jacob-wigent/esp32-handheld/README.md

# ESP32-S3 Handheld Game Console
Handheld game console powered by an ESP32-S3, featuring a custom LED matrix display and a variety of inputs.

ESP32-S3
2020 NeoPixels (WS2812B)
