jacob-wigent/esp32-handheld/hardware/motherboard/motherboard.kicad_pcb

## KiCad design hardware/motherboard/motherboard.kicad_pcb (2025-11-28)

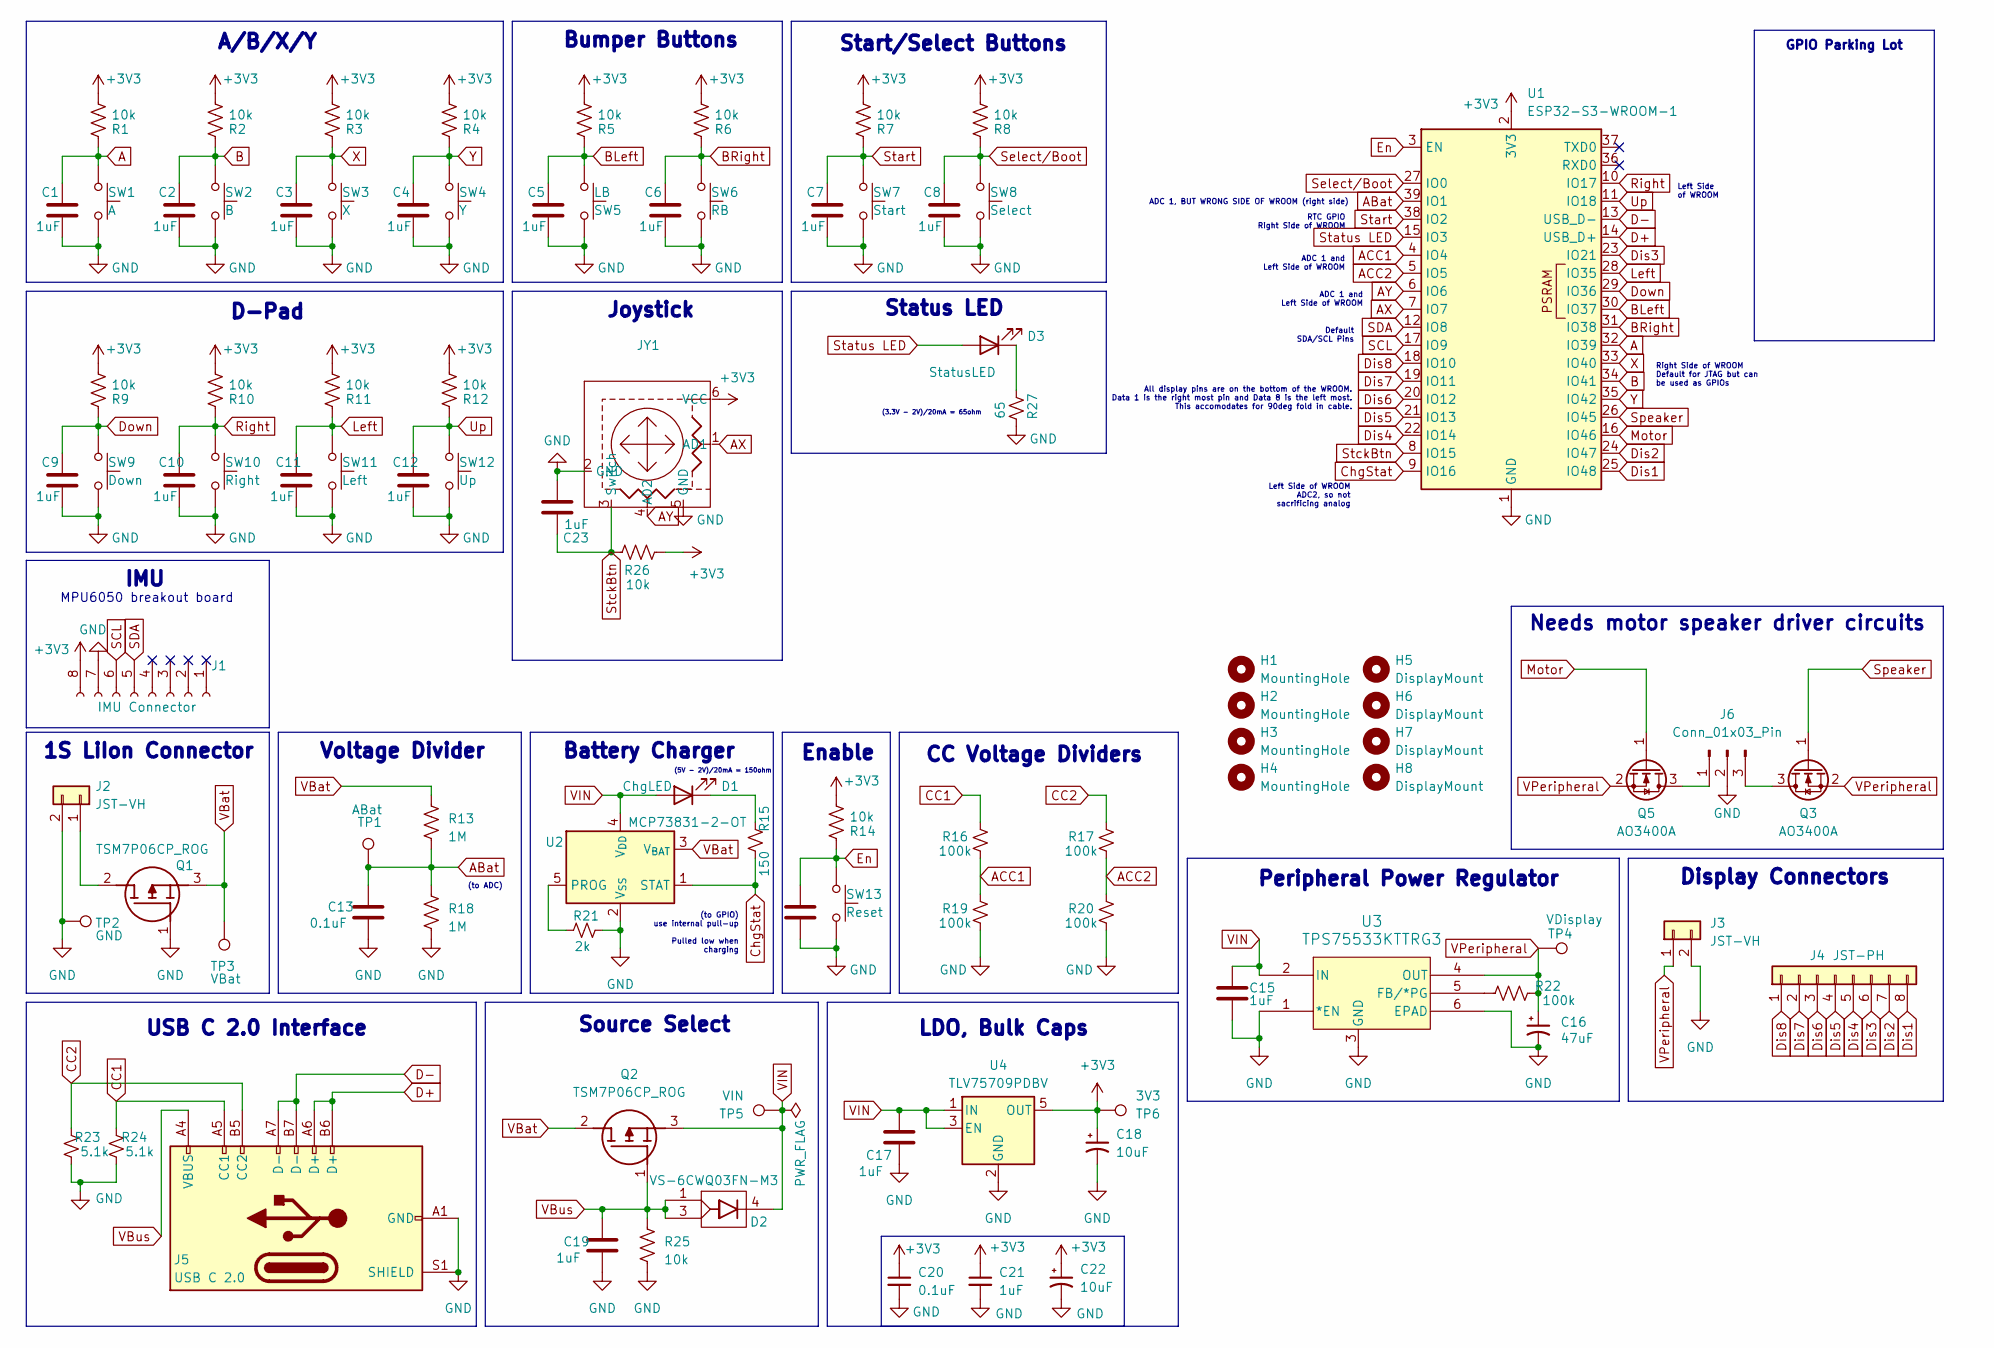
[picture p1: schematic motherboard.kicad_sch, Handheld Game Motherboard]

Parts:
C1, C2, C3, C4, C5, C6, C7, C8, C9, C10, C11, C12, C14, C15, C17, C19, C21, C23: 1uF; C_0805_2012Metric_Pad1.18x1.45mm_HandSolder
C13, C20: 0.1uF; C_0805_2012Metric_Pad1.18x1.45mm_HandSolder
C16: 47uF; CP_EIA-7343-31_Kemet-D
C18, C22: 10uF; C_0805_2012Metric_Pad1.18x1.45mm_HandSolder
D1: ChgLED; LED_1206_3216Metric_Pad1.42x1.75mm_HandSolder
D2: VS-6CWQ03FN-M3; DPAK_Q03FN-M3_VIS; Mouser Part Number 78-VS-6CWQ03FN-M3
D3: StatusLED; LED_1206_3216Metric_Pad1.42x1.75mm_HandSolder
H1, H2, H3, H4: MountingHole; MountingHole_3.2mm_M3_Pad
H5, H6, H7, H8: DisplayMount; MountingHole_3.2mm_M3_Pad
J1: IMU Connector; PinHeader_1x08_P2.54mm_Vertical
J2, J3: JST-VH; JST_VH_B2PS-VH_1x02_P3.96mm_Horizontal
J4: JST-PH; JST_PH_S8B-PH-K_1x08_P2.00mm_Horizontal
J5: USB C 2.0; USB_C_Receptacle_G-Switch_GT-USB-7010ASV
J6: Conn_01x03_Pin; JST_PH_S3B-PH-K_1x03_P2.00mm_Horizontal
JY1: Adafruit_Joycon
Q1, Q2: TSM7P06CP_ROG; TRANS_TSM7P06CP_ROG; Mouser Part Number 821-TSM7P06CPROG
Q3, Q5: AO3400A; SOT-23
R1, R2, R3, R4, R5, R6, R7, R8, R9, R10, R11, R12, R14, R25, R26: 10k; R_0805_2012Metric_Pad1.20x1.40mm_HandSolder
R13, R18: 1M; R_0805_2012Metric_Pad1.20x1.40mm_HandSolder
R15: 150; R_0805_2012Metric_Pad1.20x1.40mm_HandSolder
R16, R17, R19, R20, R22: 100k; R_0805_2012Metric_Pad1.20x1.40mm_HandSolder
R21: 2k; R_0805_2012Metric_Pad1.20x1.40mm_HandSolder
R23, R24: 5.1k; R_0805_2012Metric_Pad1.20x1.40mm_HandSolder
R27: 65; R_0805_2012Metric_Pad1.20x1.40mm_HandSolder
SW1: A; SW_PUSH_6mm
SW2: B; SW_PUSH_6mm
SW3: X; SW_PUSH_6mm
SW4: Y; SW_PUSH_6mm
SW5: LB; SW_Tactile_SPST_Angled_PTS645Vx58-2LFS
SW6: RB; SW_Tactile_SPST_Angled_PTS645Vx58-2LFS
SW7: Start; SW_PUSH_6mm
SW8: Select; SW_PUSH_6mm
SW9: Down; SW_PUSH_6mm
SW10: Right; SW_PUSH_6mm
SW11: Left; SW_PUSH_6mm
SW12: Up; SW_PUSH_6mm
SW13: Reset; SW_SPST_CK_RS282G05A3
TP1: ABat; TestPoint_Pad_D1.5mm
TP2: GND; TestPoint_Pad_D1.5mm
TP3: VBat; TestPoint_Pad_D1.5mm
TP4: VDisplay; TestPoint_Pad_D1.5mm
TP5: VIN; TestPoint_Pad_D1.5mm
TP6: 3V3; TestPoint_Pad_D1.5mm
U1: ESP32-S3-WROOM-1
U2: MCP73831-2-OT; SOT-23-5
U3: TPS75533KTTRG3; KTT5_6P22X6P86
U4: TLV75709PDBV; SOT-23-5

Connections:
+3V3: C18.1, C20.1, C21.1, C22.1, J1.8, JY1.6 (VCC), R1.2, R2.2, R3.2, R4.2, R5.2, R6.2, R7.2, R8.2, R9.2, R10.2, R11.2, R12.2, R14.2, R26.1, TP6.1, U1.2 (3V3), U4.5 (OUT)
A: C1.1, R1.1, SW1.1, U1.32 (IO39)
ABat: C13.1, R13.2, R18.1, TP1.1, U1.39 (IO1)
ACC1: R16.1, R19.2, U1.4 (IO4)
ACC2: R17.1, R20.2, U1.5 (IO5)
AX: JY1.1 (AD1), U1.7 (IO7)
AY: JY1.4 (AD2), U1.6 (IO6)
B: C2.1, R2.1, SW2.1, U1.34 (IO41)
BLeft: C5.1, R5.1, SW5.2, U1.30 (IO37)
BRight: C6.1, R6.1, SW6.1, U1.31 (IO38)
CC1: J5.A5 (CC1), R16.2, R24.2
CC2: J5.B5 (CC2), R17.2, R23.2
ChgStat: R15.1, U1.9 (IO16), U2.1 (STAT)
D+: J5.A6 (D+), J5.B6 (D+), U1.14 (USB_D+)
D-: J5.A7 (D-), J5.B7 (D-), U1.13 (USB_D-)
Dis1: J4.8, U1.25 (IO48)
Dis2: J4.7, U1.24 (IO47)
Dis3: J4.6, U1.23 (IO21)
Dis4: J4.5, U1.22 (IO14)
Dis5: J4.4, U1.21 (IO13)
Dis6: J4.3, U1.20 (IO12)
Dis7: J4.2, U1.19 (IO11)
Dis8: J4.1, U1.18 (IO10)
Down: C9.1, R9.1, SW9.1, U1.29 (IO36)
En: C14.1, R14.1, SW13.1, U1.3 (EN)
GND: C1.2, C2.2, C3.2, C4.2, C5.2, C6.2, C7.2, C8.2, C9.2, C10.2, C11.2, C12.2, C13.2, C14.2, C15.2, C16.2, C17.2, C18.2, C19.2, C20.2, C21.2, C22.2, C23.1, J1.7, J2.2, J3.2, J5.A1 (GND), J5.A12 (GND), J5.B1 (GND), J5.B12 (GND), J5.S1 (SHIELD), J6.2, JY1.2 (GND), JY1.5 (GND), Q1.1 (G), R18.2, R19.1, R20.1, R21.2, R23.1, R24.1, R25.2, R27.1, SW1.2, SW2.2, SW3.2, SW4.2, SW5.1, SW6.2, SW7.2, SW8.2, SW9.2, SW10.2, SW11.2, SW12.2, SW13.2, TP2.1, U1.1 (GND), U1.40 (GND), U1.41 (GND), U2.2 (V_{SS}), U3.1 (*EN), U3.3 (GND), U3.6 (EPAD), U4.2 (GND)
Left: C11.1, R11.1, SW11.1, U1.28 (IO35)
Motor: Q5.1 (G), U1.16 (IO46)
unnamed: D1.1 (K), R15.2
unnamed: D3.1 (K), R27.2
unnamed: J2.1, Q1.2 (D)
unnamed: J6.1, Q5.3 (D)
unnamed: J6.3, Q3.3 (D)
unnamed: R21.1, U2.5 (PROG)
unnamed: R22.1, U3.5 (FB/*PG)
Right: C10.1, R10.1, SW10.1, U1.10 (IO17)
SCL: J1.6, U1.17 (IO9)
SDA: J1.5, U1.12 (IO8)
Select/Boot: C8.1, R8.1, SW8.1, U1.27 (IO0)
Speaker: Q3.1 (G), U1.26 (IO45)
Start: C7.1, R7.1, SW7.1, U1.38 (IO2)
Status LED: D3.2 (A), U1.15 (IO3)
StckBtn: C23.2, JY1.3 (Switch), R26.2, U1.8 (IO15)
Up: C12.1, R12.1, SW12.1, U1.11 (IO18)
VBat: Q1.3 (S), Q2.2 (D), R13.1, TP3.1, U2.3 (V_{BAT})
VBus: C19.1, D2.1, D2.3, J5.A4 (VBUS), J5.A9 (VBUS), J5.B4 (VBUS), J5.B9 (VBUS), Q2.1 (G), R25.1
VIN: C15.1, C17.1, D1.2 (A), D2.4, Q2.3 (S), TP5.1, U2.4 (V_{DD}), U3.2 (IN), U4.1 (IN), U4.3 (EN)
VPeripheral: C16.1, J3.1, Q3.2 (S), Q5.2 (S), R22.2, TP4.1, U3.4 (OUT)
X: C3.1, R3.1, SW3.1, U1.33 (IO40)
Y: C4.1, R4.1, SW4.1, U1.35 (IO42)

Notes on the sheet:
(to GPIO) use internal pull-up Pulled low when charging
LDO, Bulk Caps
Left Side of WROOM
Bumper Buttons
Needs motor speaker driver circuits
Display Connectors
ADC 1 and Left Side of WROOM
Start/Select Buttons
USB C 2.0 Interface
1S LiIon Connector
CC Voltage Dividers
Right Side of WROOM Default for JTAG but can be used as GPIOs
Peripheral Power Regulator
Voltage Divider
D-Pad
(5V - 2V)/20mA = 150ohm
Source Select
IMU
(3.3V - 2V)/20mA = 65ohm
A/B/X/Y
All display pins are on the bottom of the WROOM. Data 1 is the right most pin and Data 8 is the left most. This accomodates for 90deg fold in cable.
MPU6050 breakout board
ADC 1, BUT WRONG SIDE OF WROOM (right side)
RTC GPIO Right Side of WROOM
Enable
Battery Charger
Joystick
GPIO Parking Lot
Left Side of WROOM ADC2, so not sacrificing analog
(to ADC)
Default SDA/SCL Pins
Status LED

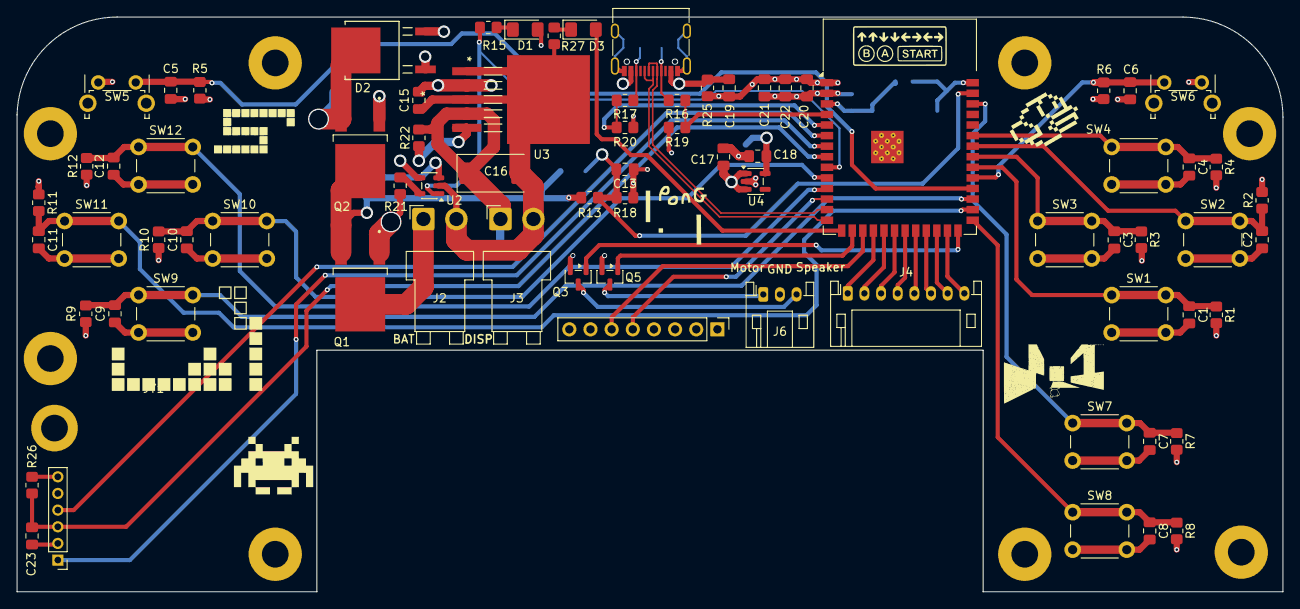
[picture p2: board motherboard.kicad_pcb from above]

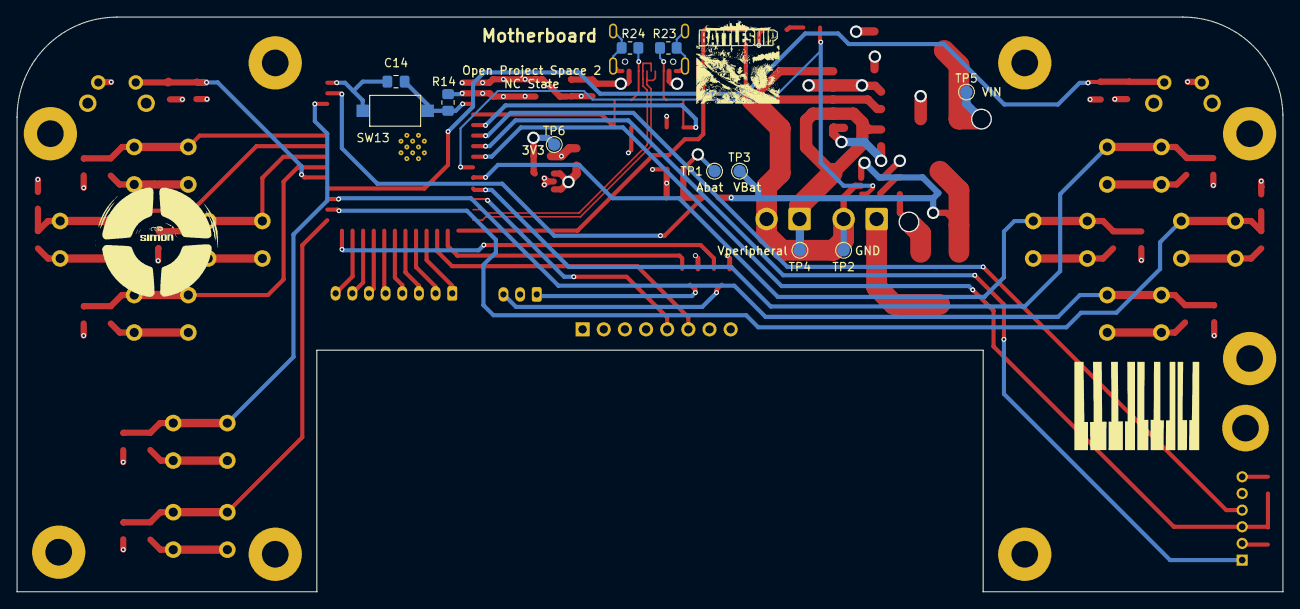
[picture p3: board motherboard.kicad_pcb from below]

Board: 4 copper layers, 152.0 x 69.0 mm, 95 parts (11 on the bottom side), 50 nets.
