jacob-wigent/esp32-handheld/hardware/display/display.kicad_pcb

## KiCad design hardware/display/display.kicad_pcb (2025-11-05)

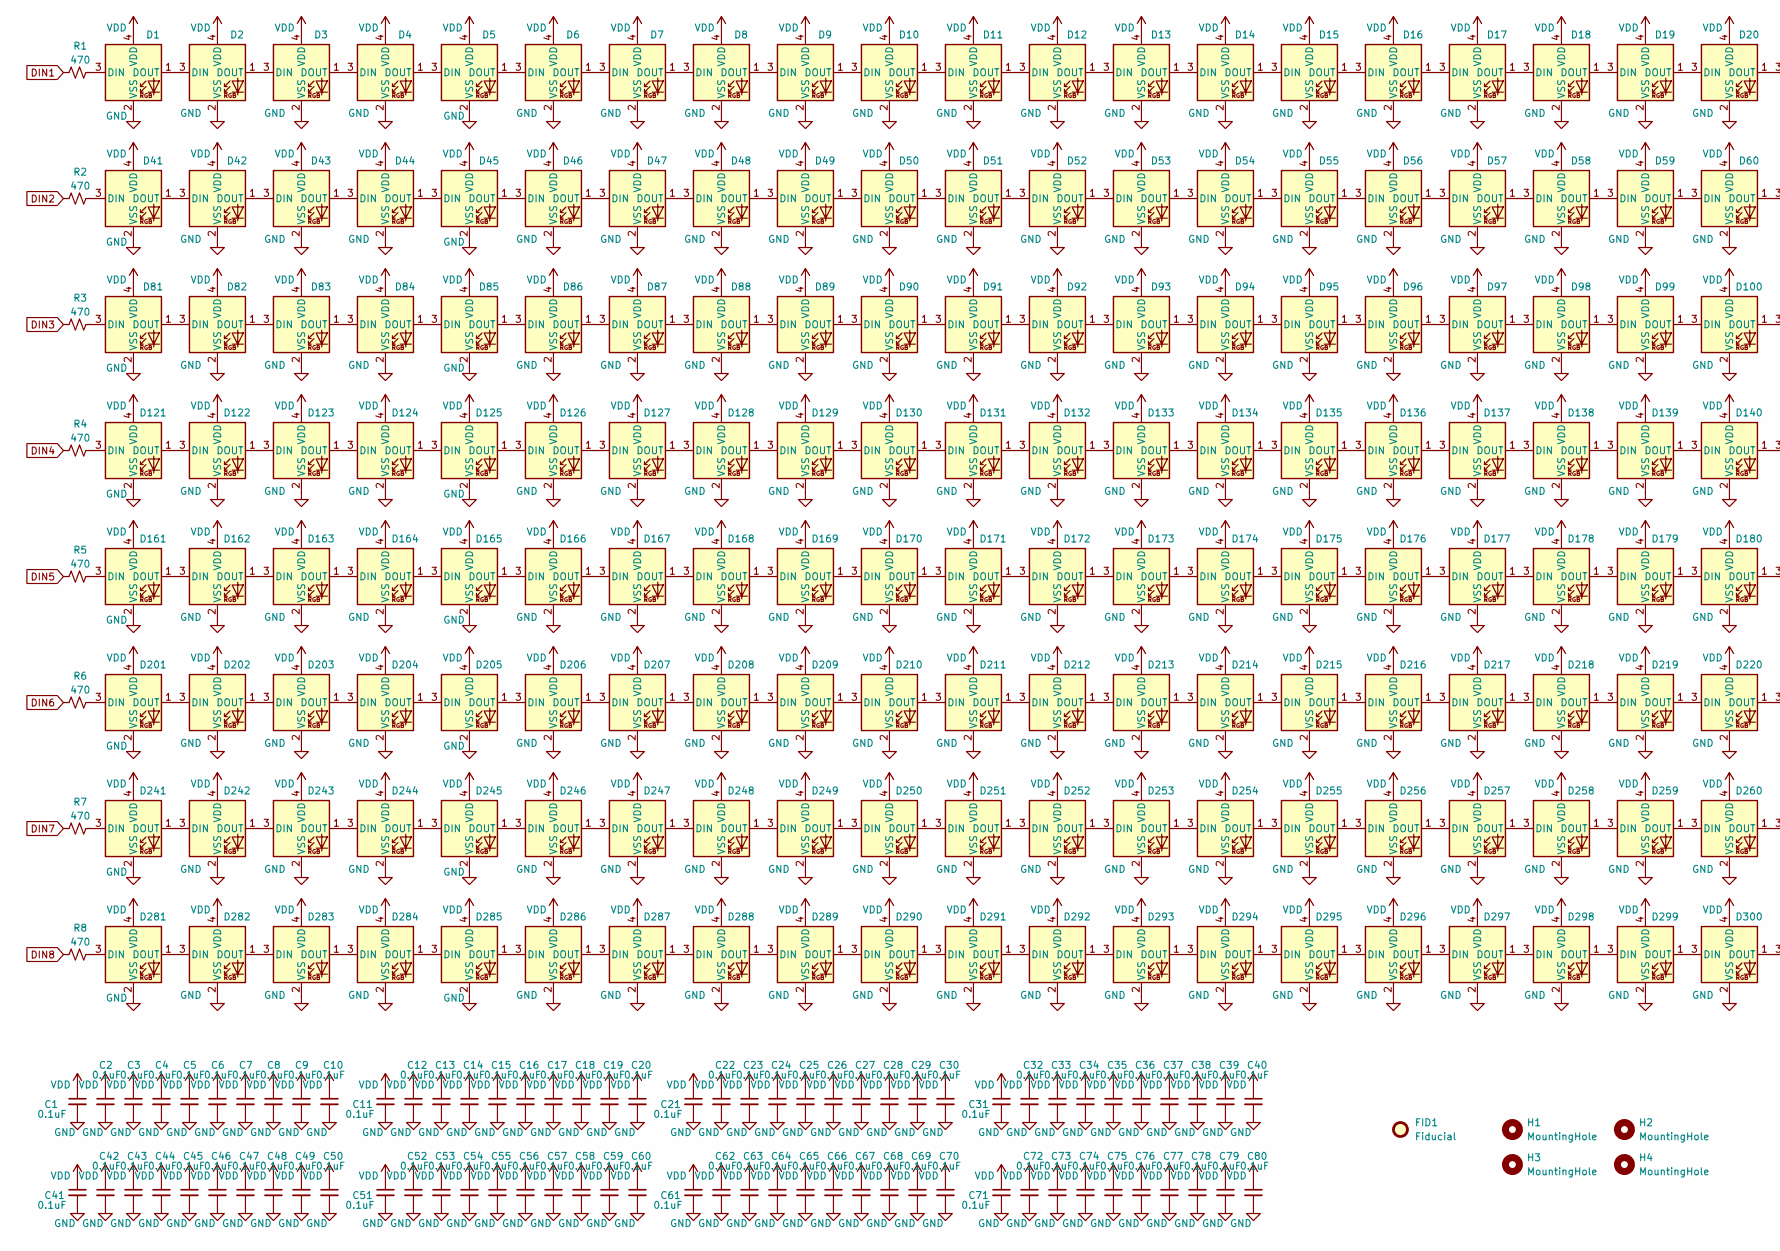
[picture p4: schematic display.kicad_sch, Display Board, part in row 1, column 1]

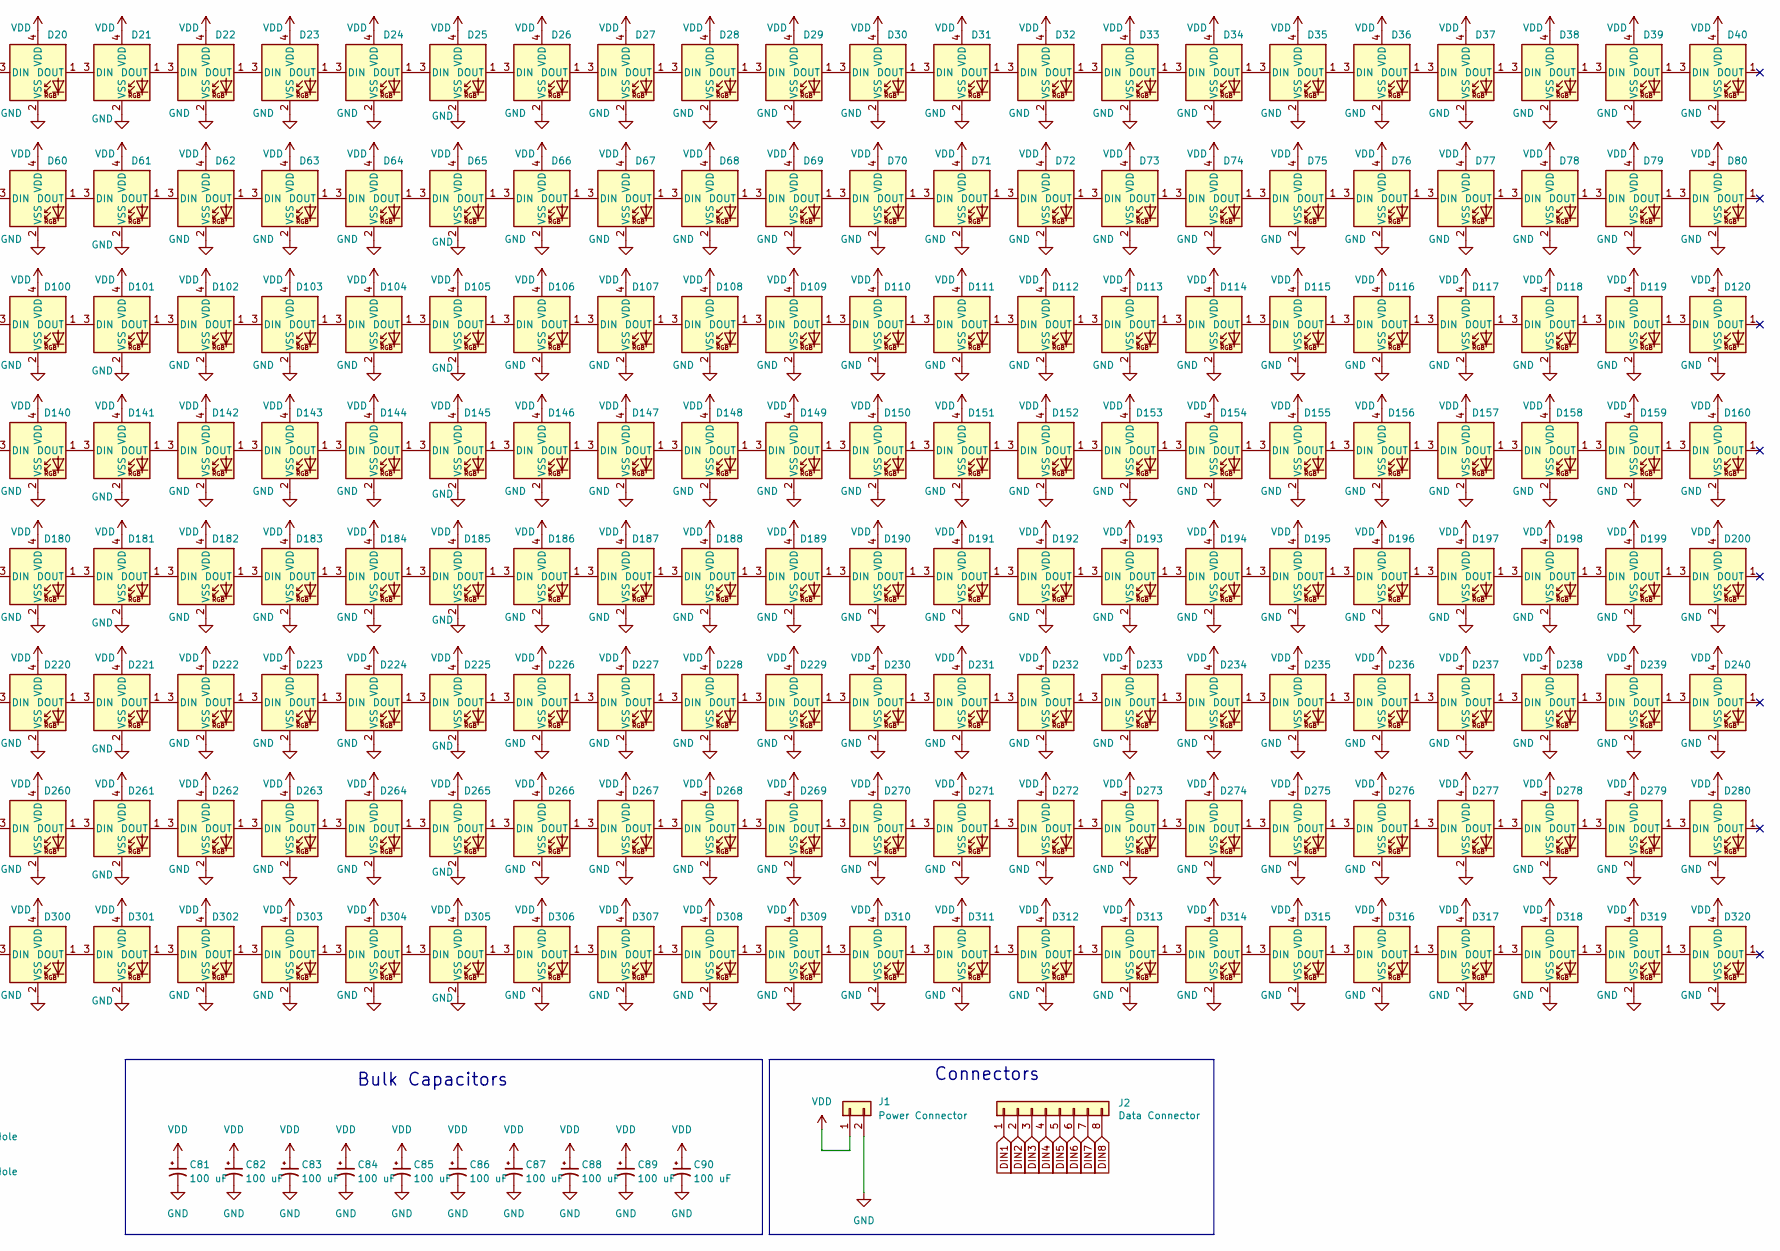
[picture p5: schematic display.kicad_sch, Display Board, part in row 1, column 2]

Parts:
C1, C2, C3, C4, C5, C6, C7, C8, C9, C10, C11, C12, C13, C14, C15, C16, C17, C18, C19, C20, C21, C22, C23, C24, C25, C26, C27, C28, C29, C30, C31, C32, C33, C34, C35, C36, C37, C38, C39, C40, C41, C42, C43, C44, C45, C46, C47, C48, C49, C50, C51, C52, C53, C54, C55, C56, C57, C58, C59, C60, C61, C62, C63, C64, C65, C66, C67, C68, C69, C70, C71, C72, C73, C74, C75, C76, C77, C78, C79, C80: 0.1uF; C_0402_1005Metric_Pad0.74x0.62mm_HandSolder
C81, C82, C83, C84, C85, C86, C87, C88, C89, C90: 100 uF; CAP_TAJ-D- 2917-S_AVX_NO_RESTRICTION
D1, D2, D3, D4, D5, D6, D7, D8, D9, D10, D11, D12, D13, D14, D15, D16, D17, D18, D19, D20, D21, D22, D23, D24, D25, D26, D27, D28, D29, D30, D31, D32, D33, D34, D35, D36, D37, D38, D39, D40, D41, D42, D43, D44, D45, D46, D47, D48, D49, D50, D51, D52, D53, D54, D55, D56, D57, D58, D59, D60, D61, D62, D63, D64, D65, D66, D67, D68, D69, D70, D71, D72, D73, D74, D75, D76, D77, D78, D79, D80, D81, D82, D83, D84, D85, D86, D87, D88, D89, D90, D91, D92, D93, D94, D95, D96, D97, D98, D99, D100, D101, D102, D103, D104, D105, D106, D107, D108, D109, D110, D111, D112, D113, D114, D115, D116, D117, D118, D119, D120, D121, D122, D123, D124, D125, D126, D127, D128, D129, D130, D131, D132, D133, D134, D135, D136, D137, D138, D139, D140, D141, D142, D143, D144, D145, D146, D147, D148, D149, D150, D151, D152, D153, D154, D155, D156, D157, D158, D159, D160, D161, D162, D163, D164, D165, D166, D167, D168, D169, D170, D171, D172, D173, D174, D175, D176, D177, D178, D179, D180, D181, D182, D183, D184, D185, D186, D187, D188, D189, D190, D191, D192, D193, D194, D195, D196, D197, D198, D199, D200, D201, D202, D203, D204, D205, D206, D207, D208, D209, D210, D211, D212, D213, D214, D215, D216, D217, D218, D219, D220, D221, D222, D223, D224, D225, D226, D227, D228, D229, D230, D231, D232, D233, D234, D235, D236, D237, D238, D239, D240, D241, D242, D243, D244, D245, D246, D247, D248, D249, D250, D251, D252, D253, D254, D255, D256, D257, D258, D259, D260, D261, D262, D263, D264, D265, D266, D267, D268, D269, D270, D271, D272, D273, D274, D275, D276, D277, D278, D279, D280, D281, D282, D283, D284, D285, D286, D287, D288, D289, D290, D291, D292, D293, D294, D295, D296, D297, D298, D299, D300, D301, D302, D303, D304, D305, D306, D307, D308, D309, D310, D311, D312, D313, D314, D315, D316, D317, D318, D319, D320: WS2812B-2020; LED_WS2812B-2020_PLCC4_2.0x2.0mm
FID1: Fiducial; Fiducial_1mm_Mask2mm
H1, H2, H3, H4: MountingHole; MountingHole_3.2mm_M3_Pad
J1: Power Connector; JST_VH_B2PS-VH_1x02_P3.96mm_Horizontal
J2: Data Connector; JST_PH_S8B-PH-K_1x08_P2.00mm_Horizontal
R1, R2, R3, R4, R5, R6, R7, R8: 470; R_0603_1608Metric_Pad0.98x0.95mm_HandSolder

Connections:
DIN1: J2.1, R1.1
DIN2: J2.2, R2.1
DIN3: J2.3, R3.1
DIN4: J2.4, R4.1
DIN5: J2.5, R5.1
DIN6: J2.6, R6.1
DIN7: J2.7, R7.1
DIN8: J2.8, R8.1
GND: C1.2, C2.2, C3.2, C4.2, C5.2, C6.2, C7.2, C8.2, C9.2, C10.2, C11.2, C12.2, C13.2, C14.2, C15.2, C16.2, C17.2, C18.2, C19.2, C20.2, C21.2, C22.2, C23.2, C24.2, C25.2, C26.2, C27.2, C28.2, C29.2, C30.2, C31.2, C32.2, C33.2, C34.2, C35.2, C36.2, C37.2, C38.2, C39.2, C40.2, C41.2, C42.2, C43.2, C44.2, C45.2, C46.2, C47.2, C48.2, C49.2, C50.2, C51.2, C52.2, C53.2, C54.2, C55.2, C56.2, C57.2, C58.2, C59.2, C60.2, C61.2, C62.2, C63.2, C64.2, C65.2, C66.2, C67.2, C68.2, C69.2, C70.2, C71.2, C72.2, C73.2, C74.2, C75.2, C76.2, C77.2, C78.2, C79.2, C80.2, C81.2, C82.2, C83.2, C84.2, C85.2, C86.2, C87.2, C88.2, C89.2, C90.2, D1.2 (VSS), D2.2 (VSS), D3.2 (VSS), D4.2 (VSS), D5.2 (VSS), D6.2 (VSS), D7.2 (VSS), D8.2 (VSS), D9.2 (VSS), D10.2 (VSS), D11.2 (VSS), D12.2 (VSS), D13.2 (VSS), D14.2 (VSS), D15.2 (VSS), D16.2 (VSS), D17.2 (VSS), D18.2 (VSS), D19.2 (VSS), D20.2 (VSS), D21.2 (VSS), D22.2 (VSS), D23.2 (VSS), D24.2 (VSS), D25.2 (VSS), D26.2 (VSS), D27.2 (VSS), D28.2 (VSS), D29.2 (VSS), D30.2 (VSS), D31.2 (VSS), D32.2 (VSS), D33.2 (VSS), D34.2 (VSS), D35.2 (VSS), D36.2 (VSS), D37.2 (VSS), D38.2 (VSS), D39.2 (VSS), D40.2 (VSS), D41.2 (VSS), D42.2 (VSS), D43.2 (VSS), D44.2 (VSS), D45.2 (VSS), D46.2 (VSS), D47.2 (VSS), D48.2 (VSS), D49.2 (VSS), D50.2 (VSS), D51.2 (VSS), D52.2 (VSS), D53.2 (VSS), D54.2 (VSS), D55.2 (VSS), D56.2 (VSS), D57.2 (VSS), D58.2 (VSS), D59.2 (VSS), D60.2 (VSS), D61.2 (VSS), D62.2 (VSS), D63.2 (VSS), D64.2 (VSS), D65.2 (VSS), D66.2 (VSS), D67.2 (VSS), D68.2 (VSS), D69.2 (VSS), D70.2 (VSS), D71.2 (VSS), D72.2 (VSS), D73.2 (VSS), D74.2 (VSS), D75.2 (VSS), D76.2 (VSS), D77.2 (VSS), D78.2 (VSS), D79.2 (VSS), D80.2 (VSS), D81.2 (VSS), D82.2 (VSS), D83.2 (VSS), D84.2 (VSS), D85.2 (VSS), D86.2 (VSS), D87.2 (VSS), D88.2 (VSS), D89.2 (VSS), D90.2 (VSS), D91.2 (VSS), D92.2 (VSS), D93.2 (VSS), D94.2 (VSS), D95.2 (VSS), D96.2 (VSS), D97.2 (VSS), D98.2 (VSS), D99.2 (VSS), D100.2 (VSS), D101.2 (VSS), D102.2 (VSS), D103.2 (VSS), D104.2 (VSS), D105.2 (VSS), D106.2 (VSS), D107.2 (VSS), D108.2 (VSS), D109.2 (VSS), D110.2 (VSS), D111.2 (VSS), D112.2 (VSS), D113.2 (VSS), D114.2 (VSS), D115.2 (VSS), D116.2 (VSS), D117.2 (VSS), D118.2 (VSS), D119.2 (VSS), D120.2 (VSS), D121.2 (VSS), D122.2 (VSS), D123.2 (VSS), D124.2 (VSS), D125.2 (VSS), D126.2 (VSS), D127.2 (VSS), D128.2 (VSS), D129.2 (VSS), D130.2 (VSS), D131.2 (VSS), D132.2 (VSS), D133.2 (VSS), D134.2 (VSS), D135.2 (VSS), D136.2 (VSS), D137.2 (VSS), D138.2 (VSS), D139.2 (VSS), D140.2 (VSS), D141.2 (VSS), D142.2 (VSS), D143.2 (VSS), D144.2 (VSS), D145.2 (VSS), D146.2 (VSS), D147.2 (VSS), D148.2 (VSS), D149.2 (VSS), D150.2 (VSS), D151.2 (VSS), D152.2 (VSS), D153.2 (VSS), D154.2 (VSS), D155.2 (VSS), D156.2 (VSS), D157.2 (VSS), D158.2 (VSS), D159.2 (VSS), D160.2 (VSS), D161.2 (VSS), D162.2 (VSS), D163.2 (VSS), D164.2 (VSS), D165.2 (VSS), D166.2 (VSS), D167.2 (VSS), D168.2 (VSS), D169.2 (VSS), D170.2 (VSS), D171.2 (VSS), D172.2 (VSS), D173.2 (VSS), D174.2 (VSS), D175.2 (VSS), D176.2 (VSS), D177.2 (VSS), D178.2 (VSS), D179.2 (VSS), D180.2 (VSS), D181.2 (VSS), D182.2 (VSS), D183.2 (VSS), D184.2 (VSS), D185.2 (VSS), D186.2 (VSS), D187.2 (VSS), D188.2 (VSS), D189.2 (VSS), D190.2 (VSS), D191.2 (VSS), D192.2 (VSS), D193.2 (VSS), D194.2 (VSS), D195.2 (VSS), D196.2 (VSS), D197.2 (VSS), D198.2 (VSS), D199.2 (VSS), D200.2 (VSS), D201.2 (VSS), D202.2 (VSS), D203.2 (VSS), D204.2 (VSS), D205.2 (VSS), D206.2 (VSS), D207.2 (VSS), D208.2 (VSS), D209.2 (VSS), D210.2 (VSS), D211.2 (VSS), D212.2 (VSS), D213.2 (VSS), D214.2 (VSS), D215.2 (VSS), D216.2 (VSS), D217.2 (VSS), D218.2 (VSS), D219.2 (VSS), D220.2 (VSS), D221.2 (VSS), D222.2 (VSS), D223.2 (VSS), D224.2 (VSS), D225.2 (VSS), D226.2 (VSS), D227.2 (VSS), D228.2 (VSS), D229.2 (VSS), D230.2 (VSS), D231.2 (VSS), D232.2 (VSS), D233.2 (VSS), D234.2 (VSS), D235.2 (VSS), D236.2 (VSS), D237.2 (VSS), D238.2 (VSS), D239.2 (VSS), D240.2 (VSS), D241.2 (VSS), D242.2 (VSS), D243.2 (VSS), D244.2 (VSS), D245.2 (VSS), D246.2 (VSS), D247.2 (VSS), D248.2 (VSS), D249.2 (VSS), D250.2 (VSS), D251.2 (VSS), D252.2 (VSS), D253.2 (VSS), D254.2 (VSS), D255.2 (VSS), D256.2 (VSS), D257.2 (VSS), D258.2 (VSS), D259.2 (VSS), D260.2 (VSS), D261.2 (VSS), D262.2 (VSS), D263.2 (VSS), D264.2 (VSS), D265.2 (VSS), D266.2 (VSS), D267.2 (VSS), D268.2 (VSS), D269.2 (VSS), D270.2 (VSS), D271.2 (VSS), D272.2 (VSS), D273.2 (VSS), D274.2 (VSS), D275.2 (VSS), D276.2 (VSS), D277.2 (VSS), D278.2 (VSS), D279.2 (VSS), D280.2 (VSS), D281.2 (VSS), D282.2 (VSS), D283.2 (VSS), D284.2 (VSS), D285.2 (VSS), D286.2 (VSS), D287.2 (VSS), D288.2 (VSS), D289.2 (VSS), D290.2 (VSS), D291.2 (VSS), D292.2 (VSS), D293.2 (VSS), D294.2 (VSS), D295.2 (VSS), D296.2 (VSS), D297.2 (VSS), D298.2 (VSS), D299.2 (VSS), D300.2 (VSS), D301.2 (VSS), D302.2 (VSS), D303.2 (VSS), D304.2 (VSS), D305.2 (VSS), D306.2 (VSS), D307.2 (VSS), D308.2 (VSS), D309.2 (VSS), D310.2 (VSS), D311.2 (VSS), D312.2 (VSS), D313.2 (VSS), D314.2 (VSS), D315.2 (VSS), D316.2 (VSS), D317.2 (VSS), D318.2 (VSS), D319.2 (VSS), D320.2 (VSS), J1.2
unnamed: D1.3 (DIN), R1.2
unnamed: D1.1 (DOUT), D2.3 (DIN)
unnamed: D2.1 (DOUT), D3.3 (DIN)
unnamed: D3.1 (DOUT), D4.3 (DIN)
unnamed: D4.1 (DOUT), D5.3 (DIN)
unnamed: D5.1 (DOUT), D6.3 (DIN)
unnamed: D6.1 (DOUT), D7.3 (DIN)
unnamed: D7.1 (DOUT), D8.3 (DIN)
unnamed: D8.1 (DOUT), D9.3 (DIN)
unnamed: D9.1 (DOUT), D10.3 (DIN)
unnamed: D10.1 (DOUT), D11.3 (DIN)
unnamed: D11.1 (DOUT), D12.3 (DIN)
unnamed: D12.1 (DOUT), D13.3 (DIN)
unnamed: D13.1 (DOUT), D14.3 (DIN)
unnamed: D14.1 (DOUT), D15.3 (DIN)
unnamed: D15.1 (DOUT), D16.3 (DIN)
unnamed: D16.1 (DOUT), D17.3 (DIN)
unnamed: D17.1 (DOUT), D18.3 (DIN)
unnamed: D18.1 (DOUT), D19.3 (DIN)
unnamed: D19.1 (DOUT), D20.3 (DIN)
unnamed: D20.1 (DOUT), D21.3 (DIN)
unnamed: D21.1 (DOUT), D22.3 (DIN)
unnamed: D22.1 (DOUT), D23.3 (DIN)
unnamed: D23.1 (DOUT), D24.3 (DIN)
unnamed: D24.1 (DOUT), D25.3 (DIN)
unnamed: D25.1 (DOUT), D26.3 (DIN)
unnamed: D26.1 (DOUT), D27.3 (DIN)
unnamed: D27.1 (DOUT), D28.3 (DIN)
unnamed: D28.1 (DOUT), D29.3 (DIN)
unnamed: D29.1 (DOUT), D30.3 (DIN)
unnamed: D30.1 (DOUT), D31.3 (DIN)
unnamed: D31.1 (DOUT), D32.3 (DIN)
unnamed: D32.1 (DOUT), D33.3 (DIN)
unnamed: D33.1 (DOUT), D34.3 (DIN)
unnamed: D34.1 (DOUT), D35.3 (DIN)
unnamed: D35.1 (DOUT), D36.3 (DIN)
unnamed: D36.1 (DOUT), D37.3 (DIN)
unnamed: D37.1 (DOUT), D38.3 (DIN)
unnamed: D38.1 (DOUT), D39.3 (DIN)
unnamed: D39.1 (DOUT), D40.3 (DIN)
unnamed: D41.3 (DIN), R2.2
unnamed: D41.1 (DOUT), D42.3 (DIN)
unnamed: D42.1 (DOUT), D43.3 (DIN)
unnamed: D43.1 (DOUT), D44.3 (DIN)
unnamed: D44.1 (DOUT), D45.3 (DIN)
unnamed: D45.1 (DOUT), D46.3 (DIN)
unnamed: D46.1 (DOUT), D47.3 (DIN)
unnamed: D47.1 (DOUT), D48.3 (DIN)
unnamed: D48.1 (DOUT), D49.3 (DIN)
unnamed: D49.1 (DOUT), D50.3 (DIN)
unnamed: D50.1 (DOUT), D51.3 (DIN)
unnamed: D51.1 (DOUT), D52.3 (DIN)
unnamed: D52.1 (DOUT), D53.3 (DIN)
unnamed: D53.1 (DOUT), D54.3 (DIN)
unnamed: D54.1 (DOUT), D55.3 (DIN)
unnamed: D55.1 (DOUT), D56.3 (DIN)
unnamed: D56.1 (DOUT), D57.3 (DIN)
unnamed: D57.1 (DOUT), D58.3 (DIN)
unnamed: D58.1 (DOUT), D59.3 (DIN)
unnamed: D59.1 (DOUT), D60.3 (DIN)
unnamed: D60.1 (DOUT), D61.3 (DIN)
unnamed: D61.1 (DOUT), D62.3 (DIN)
unnamed: D62.1 (DOUT), D63.3 (DIN)
unnamed: D63.1 (DOUT), D64.3 (DIN)
unnamed: D64.1 (DOUT), D65.3 (DIN)
unnamed: D65.1 (DOUT), D66.3 (DIN)
unnamed: D66.1 (DOUT), D67.3 (DIN)
unnamed: D67.1 (DOUT), D68.3 (DIN)
unnamed: D68.1 (DOUT), D69.3 (DIN)
unnamed: D69.1 (DOUT), D70.3 (DIN)
unnamed: D70.1 (DOUT), D71.3 (DIN)
unnamed: D71.1 (DOUT), D72.3 (DIN)
unnamed: D72.1 (DOUT), D73.3 (DIN)
unnamed: D73.1 (DOUT), D74.3 (DIN)
unnamed: D74.1 (DOUT), D75.3 (DIN)
unnamed: D75.1 (DOUT), D76.3 (DIN)
unnamed: D76.1 (DOUT), D77.3 (DIN)
unnamed: D77.1 (DOUT), D78.3 (DIN)
unnamed: D78.1 (DOUT), D79.3 (DIN)
unnamed: D79.1 (DOUT), D80.3 (DIN)
unnamed: D81.3 (DIN), R3.2
unnamed: D81.1 (DOUT), D82.3 (DIN)
unnamed: D82.1 (DOUT), D83.3 (DIN)
unnamed: D83.1 (DOUT), D84.3 (DIN)
unnamed: D84.1 (DOUT), D85.3 (DIN)
unnamed: D85.1 (DOUT), D86.3 (DIN)
unnamed: D86.1 (DOUT), D87.3 (DIN)
unnamed: D87.1 (DOUT), D88.3 (DIN)
unnamed: D88.1 (DOUT), D89.3 (DIN)
unnamed: D89.1 (DOUT), D90.3 (DIN)
unnamed: D90.1 (DOUT), D91.3 (DIN)
unnamed: D91.1 (DOUT), D92.3 (DIN)
unnamed: D92.1 (DOUT), D93.3 (DIN)
unnamed: D93.1 (DOUT), D94.3 (DIN)
unnamed: D94.1 (DOUT), D95.3 (DIN)
unnamed: D95.1 (DOUT), D96.3 (DIN)
unnamed: D96.1 (DOUT), D97.3 (DIN)
unnamed: D97.1 (DOUT), D98.3 (DIN)
unnamed: D98.1 (DOUT), D99.3 (DIN)
unnamed: D99.1 (DOUT), D100.3 (DIN)
unnamed: D100.1 (DOUT), D101.3 (DIN)
unnamed: D101.1 (DOUT), D102.3 (DIN)
unnamed: D102.1 (DOUT), D103.3 (DIN)
unnamed: D103.1 (DOUT), D104.3 (DIN)
unnamed: D104.1 (DOUT), D105.3 (DIN)
unnamed: D105.1 (DOUT), D106.3 (DIN)
unnamed: D106.1 (DOUT), D107.3 (DIN)
unnamed: D107.1 (DOUT), D108.3 (DIN)
unnamed: D108.1 (DOUT), D109.3 (DIN)
unnamed: D109.1 (DOUT), D110.3 (DIN)
unnamed: D110.1 (DOUT), D111.3 (DIN)
unnamed: D111.1 (DOUT), D112.3 (DIN)
unnamed: D112.1 (DOUT), D113.3 (DIN)
unnamed: D113.1 (DOUT), D114.3 (DIN)
unnamed: D114.1 (DOUT), D115.3 (DIN)
unnamed: D115.1 (DOUT), D116.3 (DIN)
unnamed: D116.1 (DOUT), D117.3 (DIN)
unnamed: D117.1 (DOUT), D118.3 (DIN)
unnamed: D118.1 (DOUT), D119.3 (DIN)
unnamed: D119.1 (DOUT), D120.3 (DIN)
unnamed: D121.3 (DIN), R4.2
unnamed: D121.1 (DOUT), D122.3 (DIN)
unnamed: D122.1 (DOUT), D123.3 (DIN)
unnamed: D123.1 (DOUT), D124.3 (DIN)
unnamed: D124.1 (DOUT), D125.3 (DIN)
unnamed: D125.1 (DOUT), D126.3 (DIN)
unnamed: D126.1 (DOUT), D127.3 (DIN)
unnamed: D127.1 (DOUT), D128.3 (DIN)
unnamed: D128.1 (DOUT), D129.3 (DIN)
unnamed: D129.1 (DOUT), D130.3 (DIN)
unnamed: D130.1 (DOUT), D131.3 (DIN)
unnamed: D131.1 (DOUT), D132.3 (DIN)
unnamed: D132.1 (DOUT), D133.3 (DIN)
unnamed: D133.1 (DOUT), D134.3 (DIN)
unnamed: D134.1 (DOUT), D135.3 (DIN)
unnamed: D135.1 (DOUT), D136.3 (DIN)
unnamed: D136.1 (DOUT), D137.3 (DIN)
unnamed: D137.1 (DOUT), D138.3 (DIN)
unnamed: D138.1 (DOUT), D139.3 (DIN)
unnamed: D139.1 (DOUT), D140.3 (DIN)
unnamed: D140.1 (DOUT), D141.3 (DIN)
unnamed: D141.1 (DOUT), D142.3 (DIN)
unnamed: D142.1 (DOUT), D143.3 (DIN)
unnamed: D143.1 (DOUT), D144.3 (DIN)
unnamed: D144.1 (DOUT), D145.3 (DIN)
unnamed: D145.1 (DOUT), D146.3 (DIN)
unnamed: D146.1 (DOUT), D147.3 (DIN)
unnamed: D147.1 (DOUT), D148.3 (DIN)
unnamed: D148.1 (DOUT), D149.3 (DIN)
unnamed: D149.1 (DOUT), D150.3 (DIN)
unnamed: D150.1 (DOUT), D151.3 (DIN)
unnamed: D151.1 (DOUT), D152.3 (DIN)
unnamed: D152.1 (DOUT), D153.3 (DIN)
unnamed: D153.1 (DOUT), D154.3 (DIN)
unnamed: D154.1 (DOUT), D155.3 (DIN)
unnamed: D155.1 (DOUT), D156.3 (DIN)
unnamed: D156.1 (DOUT), D157.3 (DIN)
unnamed: D157.1 (DOUT), D158.3 (DIN)
unnamed: D158.1 (DOUT), D159.3 (DIN)
unnamed: D159.1 (DOUT), D160.3 (DIN)
unnamed: D161.3 (DIN), R5.2
unnamed: D161.1 (DOUT), D162.3 (DIN)
unnamed: D162.1 (DOUT), D163.3 (DIN)
unnamed: D163.1 (DOUT), D164.3 (DIN)
unnamed: D164.1 (DOUT), D165.3 (DIN)
unnamed: D165.1 (DOUT), D166.3 (DIN)
unnamed: D166.1 (DOUT), D167.3 (DIN)
unnamed: D167.1 (DOUT), D168.3 (DIN)
unnamed: D168.1 (DOUT), D169.3 (DIN)
unnamed: D169.1 (DOUT), D170.3 (DIN)
unnamed: D170.1 (DOUT), D171.3 (DIN)
unnamed: D171.1 (DOUT), D172.3 (DIN)
unnamed: D172.1 (DOUT), D173.3 (DIN)
unnamed: D173.1 (DOUT), D174.3 (DIN)
unnamed: D174.1 (DOUT), D175.3 (DIN)
unnamed: D175.1 (DOUT), D176.3 (DIN)
unnamed: D176.1 (DOUT), D177.3 (DIN)
unnamed: D177.1 (DOUT), D178.3 (DIN)
unnamed: D178.1 (DOUT), D179.3 (DIN)
unnamed: D179.1 (DOUT), D180.3 (DIN)
unnamed: D180.1 (DOUT), D181.3 (DIN)
unnamed: D181.1 (DOUT), D182.3 (DIN)
unnamed: D182.1 (DOUT), D183.3 (DIN)
unnamed: D183.1 (DOUT), D184.3 (DIN)
unnamed: D184.1 (DOUT), D185.3 (DIN)
unnamed: D185.1 (DOUT), D186.3 (DIN)
unnamed: D186.1 (DOUT), D187.3 (DIN)
unnamed: D187.1 (DOUT), D188.3 (DIN)
unnamed: D188.1 (DOUT), D189.3 (DIN)
unnamed: D189.1 (DOUT), D190.3 (DIN)
unnamed: D190.1 (DOUT), D191.3 (DIN)
unnamed: D191.1 (DOUT), D192.3 (DIN)
unnamed: D192.1 (DOUT), D193.3 (DIN)
unnamed: D193.1 (DOUT), D194.3 (DIN)
unnamed: D194.1 (DOUT), D195.3 (DIN)
unnamed: D195.1 (DOUT), D196.3 (DIN)
unnamed: D196.1 (DOUT), D197.3 (DIN)
unnamed: D197.1 (DOUT), D198.3 (DIN)
unnamed: D198.1 (DOUT), D199.3 (DIN)
unnamed: D199.1 (DOUT), D200.3 (DIN)
unnamed: D201.3 (DIN), R6.2
unnamed: D201.1 (DOUT), D202.3 (DIN)
unnamed: D202.1 (DOUT), D203.3 (DIN)
unnamed: D203.1 (DOUT), D204.3 (DIN)
unnamed: D204.1 (DOUT), D205.3 (DIN)
unnamed: D205.1 (DOUT), D206.3 (DIN)
unnamed: D206.1 (DOUT), D207.3 (DIN)
unnamed: D207.1 (DOUT), D208.3 (DIN)
unnamed: D208.1 (DOUT), D209.3 (DIN)
unnamed: D209.1 (DOUT), D210.3 (DIN)
unnamed: D210.1 (DOUT), D211.3 (DIN)
unnamed: D211.1 (DOUT), D212.3 (DIN)
unnamed: D212.1 (DOUT), D213.3 (DIN)
unnamed: D213.1 (DOUT), D214.3 (DIN)
unnamed: D214.1 (DOUT), D215.3 (DIN)
unnamed: D215.1 (DOUT), D216.3 (DIN)
unnamed: D216.1 (DOUT), D217.3 (DIN)
unnamed: D217.1 (DOUT), D218.3 (DIN)
unnamed: D218.1 (DOUT), D219.3 (DIN)
unnamed: D219.1 (DOUT), D220.3 (DIN)
unnamed: D220.1 (DOUT), D221.3 (DIN)
unnamed: D221.1 (DOUT), D222.3 (DIN)
unnamed: D222.1 (DOUT), D223.3 (DIN)
unnamed: D223.1 (DOUT), D224.3 (DIN)
unnamed: D224.1 (DOUT), D225.3 (DIN)
unnamed: D225.1 (DOUT), D226.3 (DIN)
unnamed: D226.1 (DOUT), D227.3 (DIN)
unnamed: D227.1 (DOUT), D228.3 (DIN)
unnamed: D228.1 (DOUT), D229.3 (DIN)
unnamed: D229.1 (DOUT), D230.3 (DIN)
unnamed: D230.1 (DOUT), D231.3 (DIN)
unnamed: D231.1 (DOUT), D232.3 (DIN)
unnamed: D232.1 (DOUT), D233.3 (DIN)
unnamed: D233.1 (DOUT), D234.3 (DIN)
unnamed: D234.1 (DOUT), D235.3 (DIN)
unnamed: D235.1 (DOUT), D236.3 (DIN)
unnamed: D236.1 (DOUT), D237.3 (DIN)
unnamed: D237.1 (DOUT), D238.3 (DIN)
unnamed: D238.1 (DOUT), D239.3 (DIN)
unnamed: D239.1 (DOUT), D240.3 (DIN)
unnamed: D241.3 (DIN), R7.2
unnamed: D241.1 (DOUT), D242.3 (DIN)
unnamed: D242.1 (DOUT), D243.3 (DIN)
unnamed: D243.1 (DOUT), D244.3 (DIN)
unnamed: D244.1 (DOUT), D245.3 (DIN)
unnamed: D245.1 (DOUT), D246.3 (DIN)
unnamed: D246.1 (DOUT), D247.3 (DIN)
unnamed: D247.1 (DOUT), D248.3 (DIN)
unnamed: D248.1 (DOUT), D249.3 (DIN)
unnamed: D249.1 (DOUT), D250.3 (DIN)
unnamed: D250.1 (DOUT), D251.3 (DIN)
unnamed: D251.1 (DOUT), D252.3 (DIN)
unnamed: D252.1 (DOUT), D253.3 (DIN)
unnamed: D253.1 (DOUT), D254.3 (DIN)
unnamed: D254.1 (DOUT), D255.3 (DIN)
unnamed: D255.1 (DOUT), D256.3 (DIN)
unnamed: D256.1 (DOUT), D257.3 (DIN)
unnamed: D257.1 (DOUT), D258.3 (DIN)
unnamed: D258.1 (DOUT), D259.3 (DIN)
unnamed: D259.1 (DOUT), D260.3 (DIN)
unnamed: D260.1 (DOUT), D261.3 (DIN)
unnamed: D261.1 (DOUT), D262.3 (DIN)
unnamed: D262.1 (DOUT), D263.3 (DIN)
unnamed: D263.1 (DOUT), D264.3 (DIN)
unnamed: D264.1 (DOUT), D265.3 (DIN)
unnamed: D265.1 (DOUT), D266.3 (DIN)
unnamed: D266.1 (DOUT), D267.3 (DIN)
unnamed: D267.1 (DOUT), D268.3 (DIN)
unnamed: D268.1 (DOUT), D269.3 (DIN)
unnamed: D269.1 (DOUT), D270.3 (DIN)
unnamed: D270.1 (DOUT), D271.3 (DIN)
unnamed: D271.1 (DOUT), D272.3 (DIN)
unnamed: D272.1 (DOUT), D273.3 (DIN)
unnamed: D273.1 (DOUT), D274.3 (DIN)
unnamed: D274.1 (DOUT), D275.3 (DIN)
unnamed: D275.1 (DOUT), D276.3 (DIN)
unnamed: D276.1 (DOUT), D277.3 (DIN)
unnamed: D277.1 (DOUT), D278.3 (DIN)
unnamed: D278.1 (DOUT), D279.3 (DIN)
unnamed: D279.1 (DOUT), D280.3 (DIN)
unnamed: D281.3 (DIN), R8.2
unnamed: D281.1 (DOUT), D282.3 (DIN)
unnamed: D282.1 (DOUT), D283.3 (DIN)
unnamed: D283.1 (DOUT), D284.3 (DIN)
unnamed: D284.1 (DOUT), D285.3 (DIN)
unnamed: D285.1 (DOUT), D286.3 (DIN)
unnamed: D286.1 (DOUT), D287.3 (DIN)
unnamed: D287.1 (DOUT), D288.3 (DIN)
unnamed: D288.1 (DOUT), D289.3 (DIN)
unnamed: D289.1 (DOUT), D290.3 (DIN)
unnamed: D290.1 (DOUT), D291.3 (DIN)
unnamed: D291.1 (DOUT), D292.3 (DIN)
unnamed: D292.1 (DOUT), D293.3 (DIN)
unnamed: D293.1 (DOUT), D294.3 (DIN)
unnamed: D294.1 (DOUT), D295.3 (DIN)
unnamed: D295.1 (DOUT), D296.3 (DIN)
unnamed: D296.1 (DOUT), D297.3 (DIN)
unnamed: D297.1 (DOUT), D298.3 (DIN)
unnamed: D298.1 (DOUT), D299.3 (DIN)
unnamed: D299.1 (DOUT), D300.3 (DIN)
unnamed: D300.1 (DOUT), D301.3 (DIN)
unnamed: D301.1 (DOUT), D302.3 (DIN)
unnamed: D302.1 (DOUT), D303.3 (DIN)
unnamed: D303.1 (DOUT), D304.3 (DIN)
unnamed: D304.1 (DOUT), D305.3 (DIN)
unnamed: D305.1 (DOUT), D306.3 (DIN)
unnamed: D306.1 (DOUT), D307.3 (DIN)
unnamed: D307.1 (DOUT), D308.3 (DIN)
unnamed: D308.1 (DOUT), D309.3 (DIN)
unnamed: D309.1 (DOUT), D310.3 (DIN)
unnamed: D310.1 (DOUT), D311.3 (DIN)
unnamed: D311.1 (DOUT), D312.3 (DIN)
unnamed: D312.1 (DOUT), D313.3 (DIN)
unnamed: D313.1 (DOUT), D314.3 (DIN)
unnamed: D314.1 (DOUT), D315.3 (DIN)
unnamed: D315.1 (DOUT), D316.3 (DIN)
unnamed: D316.1 (DOUT), D317.3 (DIN)
unnamed: D317.1 (DOUT), D318.3 (DIN)
unnamed: D318.1 (DOUT), D319.3 (DIN)
unnamed: D319.1 (DOUT), D320.3 (DIN)
VDD: C1.1, C2.1, C3.1, C4.1, C5.1, C6.1, C7.1, C8.1, C9.1, C10.1, C11.1, C12.1, C13.1, C14.1, C15.1, C16.1, C17.1, C18.1, C19.1, C20.1, C21.1, C22.1, C23.1, C24.1, C25.1, C26.1, C27.1, C28.1, C29.1, C30.1, C31.1, C32.1, C33.1, C34.1, C35.1, C36.1, C37.1, C38.1, C39.1, C40.1, C41.1, C42.1, C43.1, C44.1, C45.1, C46.1, C47.1, C48.1, C49.1, C50.1, C51.1, C52.1, C53.1, C54.1, C55.1, C56.1, C57.1, C58.1, C59.1, C60.1, C61.1, C62.1, C63.1, C64.1, C65.1, C66.1, C67.1, C68.1, C69.1, C70.1, C71.1, C72.1, C73.1, C74.1, C75.1, C76.1, C77.1, C78.1, C79.1, C80.1, C81.1, C82.1, C83.1, C84.1, C85.1, C86.1, C87.1, C88.1, C89.1, C90.1, D1.4 (VDD), D2.4 (VDD), D3.4 (VDD), D4.4 (VDD), D5.4 (VDD), D6.4 (VDD), D7.4 (VDD), D8.4 (VDD), D9.4 (VDD), D10.4 (VDD), D11.4 (VDD), D12.4 (VDD), D13.4 (VDD), D14.4 (VDD), D15.4 (VDD), D16.4 (VDD), D17.4 (VDD), D18.4 (VDD), D19.4 (VDD), D20.4 (VDD), D21.4 (VDD), D22.4 (VDD), D23.4 (VDD), D24.4 (VDD), D25.4 (VDD), D26.4 (VDD), D27.4 (VDD), D28.4 (VDD), D29.4 (VDD), D30.4 (VDD), D31.4 (VDD), D32.4 (VDD), D33.4 (VDD), D34.4 (VDD), D35.4 (VDD), D36.4 (VDD), D37.4 (VDD), D38.4 (VDD), D39.4 (VDD), D40.4 (VDD), D41.4 (VDD), D42.4 (VDD), D43.4 (VDD), D44.4 (VDD), D45.4 (VDD), D46.4 (VDD), D47.4 (VDD), D48.4 (VDD), D49.4 (VDD), D50.4 (VDD), D51.4 (VDD), D52.4 (VDD), D53.4 (VDD), D54.4 (VDD), D55.4 (VDD), D56.4 (VDD), D57.4 (VDD), D58.4 (VDD), D59.4 (VDD), D60.4 (VDD), D61.4 (VDD), D62.4 (VDD), D63.4 (VDD), D64.4 (VDD), D65.4 (VDD), D66.4 (VDD), D67.4 (VDD), D68.4 (VDD), D69.4 (VDD), D70.4 (VDD), D71.4 (VDD), D72.4 (VDD), D73.4 (VDD), D74.4 (VDD), D75.4 (VDD), D76.4 (VDD), D77.4 (VDD), D78.4 (VDD), D79.4 (VDD), D80.4 (VDD), D81.4 (VDD), D82.4 (VDD), D83.4 (VDD), D84.4 (VDD), D85.4 (VDD), D86.4 (VDD), D87.4 (VDD), D88.4 (VDD), D89.4 (VDD), D90.4 (VDD), D91.4 (VDD), D92.4 (VDD), D93.4 (VDD), D94.4 (VDD), D95.4 (VDD), D96.4 (VDD), D97.4 (VDD), D98.4 (VDD), D99.4 (VDD), D100.4 (VDD), D101.4 (VDD), D102.4 (VDD), D103.4 (VDD), D104.4 (VDD), D105.4 (VDD), D106.4 (VDD), D107.4 (VDD), D108.4 (VDD), D109.4 (VDD), D110.4 (VDD), D111.4 (VDD), D112.4 (VDD), D113.4 (VDD), D114.4 (VDD), D115.4 (VDD), D116.4 (VDD), D117.4 (VDD), D118.4 (VDD), D119.4 (VDD), D120.4 (VDD), D121.4 (VDD), D122.4 (VDD), D123.4 (VDD), D124.4 (VDD), D125.4 (VDD), D126.4 (VDD), D127.4 (VDD), D128.4 (VDD), D129.4 (VDD), D130.4 (VDD), D131.4 (VDD), D132.4 (VDD), D133.4 (VDD), D134.4 (VDD), D135.4 (VDD), D136.4 (VDD), D137.4 (VDD), D138.4 (VDD), D139.4 (VDD), D140.4 (VDD), D141.4 (VDD), D142.4 (VDD), D143.4 (VDD), D144.4 (VDD), D145.4 (VDD), D146.4 (VDD), D147.4 (VDD), D148.4 (VDD), D149.4 (VDD), D150.4 (VDD), D151.4 (VDD), D152.4 (VDD), D153.4 (VDD), D154.4 (VDD), D155.4 (VDD), D156.4 (VDD), D157.4 (VDD), D158.4 (VDD), D159.4 (VDD), D160.4 (VDD), D161.4 (VDD), D162.4 (VDD), D163.4 (VDD), D164.4 (VDD), D165.4 (VDD), D166.4 (VDD), D167.4 (VDD), D168.4 (VDD), D169.4 (VDD), D170.4 (VDD), D171.4 (VDD), D172.4 (VDD), D173.4 (VDD), D174.4 (VDD), D175.4 (VDD), D176.4 (VDD), D177.4 (VDD), D178.4 (VDD), D179.4 (VDD), D180.4 (VDD), D181.4 (VDD), D182.4 (VDD), D183.4 (VDD), D184.4 (VDD), D185.4 (VDD), D186.4 (VDD), D187.4 (VDD), D188.4 (VDD), D189.4 (VDD), D190.4 (VDD), D191.4 (VDD), D192.4 (VDD), D193.4 (VDD), D194.4 (VDD), D195.4 (VDD), D196.4 (VDD), D197.4 (VDD), D198.4 (VDD), D199.4 (VDD), D200.4 (VDD), D201.4 (VDD), D202.4 (VDD), D203.4 (VDD), D204.4 (VDD), D205.4 (VDD), D206.4 (VDD), D207.4 (VDD), D208.4 (VDD), D209.4 (VDD), D210.4 (VDD), D211.4 (VDD), D212.4 (VDD), D213.4 (VDD), D214.4 (VDD), D215.4 (VDD), D216.4 (VDD), D217.4 (VDD), D218.4 (VDD), D219.4 (VDD), D220.4 (VDD), D221.4 (VDD), D222.4 (VDD), D223.4 (VDD), D224.4 (VDD), D225.4 (VDD), D226.4 (VDD), D227.4 (VDD), D228.4 (VDD), D229.4 (VDD), D230.4 (VDD), D231.4 (VDD), D232.4 (VDD), D233.4 (VDD), D234.4 (VDD), D235.4 (VDD), D236.4 (VDD), D237.4 (VDD), D238.4 (VDD), D239.4 (VDD), D240.4 (VDD), D241.4 (VDD), D242.4 (VDD), D243.4 (VDD), D244.4 (VDD), D245.4 (VDD), D246.4 (VDD), D247.4 (VDD), D248.4 (VDD), D249.4 (VDD), D250.4 (VDD), D251.4 (VDD), D252.4 (VDD), D253.4 (VDD), D254.4 (VDD), D255.4 (VDD), D256.4 (VDD), D257.4 (VDD), D258.4 (VDD), D259.4 (VDD), D260.4 (VDD), D261.4 (VDD), D262.4 (VDD), D263.4 (VDD), D264.4 (VDD), D265.4 (VDD), D266.4 (VDD), D267.4 (VDD), D268.4 (VDD), D269.4 (VDD), D270.4 (VDD), D271.4 (VDD), D272.4 (VDD), D273.4 (VDD), D274.4 (VDD), D275.4 (VDD), D276.4 (VDD), D277.4 (VDD), D278.4 (VDD), D279.4 (VDD), D280.4 (VDD), D281.4 (VDD), D282.4 (VDD), D283.4 (VDD), D284.4 (VDD), D285.4 (VDD), D286.4 (VDD), D287.4 (VDD), D288.4 (VDD), D289.4 (VDD), D290.4 (VDD), D291.4 (VDD), D292.4 (VDD), D293.4 (VDD), D294.4 (VDD), D295.4 (VDD), D296.4 (VDD), D297.4 (VDD), D298.4 (VDD), D299.4 (VDD), D300.4 (VDD), D301.4 (VDD), D302.4 (VDD), D303.4 (VDD), D304.4 (VDD), D305.4 (VDD), D306.4 (VDD), D307.4 (VDD), D308.4 (VDD), D309.4 (VDD), D310.4 (VDD), D311.4 (VDD), D312.4 (VDD), D313.4 (VDD), D314.4 (VDD), D315.4 (VDD), D316.4 (VDD), D317.4 (VDD), D318.4 (VDD), D319.4 (VDD), D320.4 (VDD), J1.1

Notes on the sheet:
Bulk Capacitors
Connectors
