jacob-wigent/esp32-handheld/hardware/display/display.kicad_pcb

## KiCad design hardware/display/display.kicad_pcb (continued)

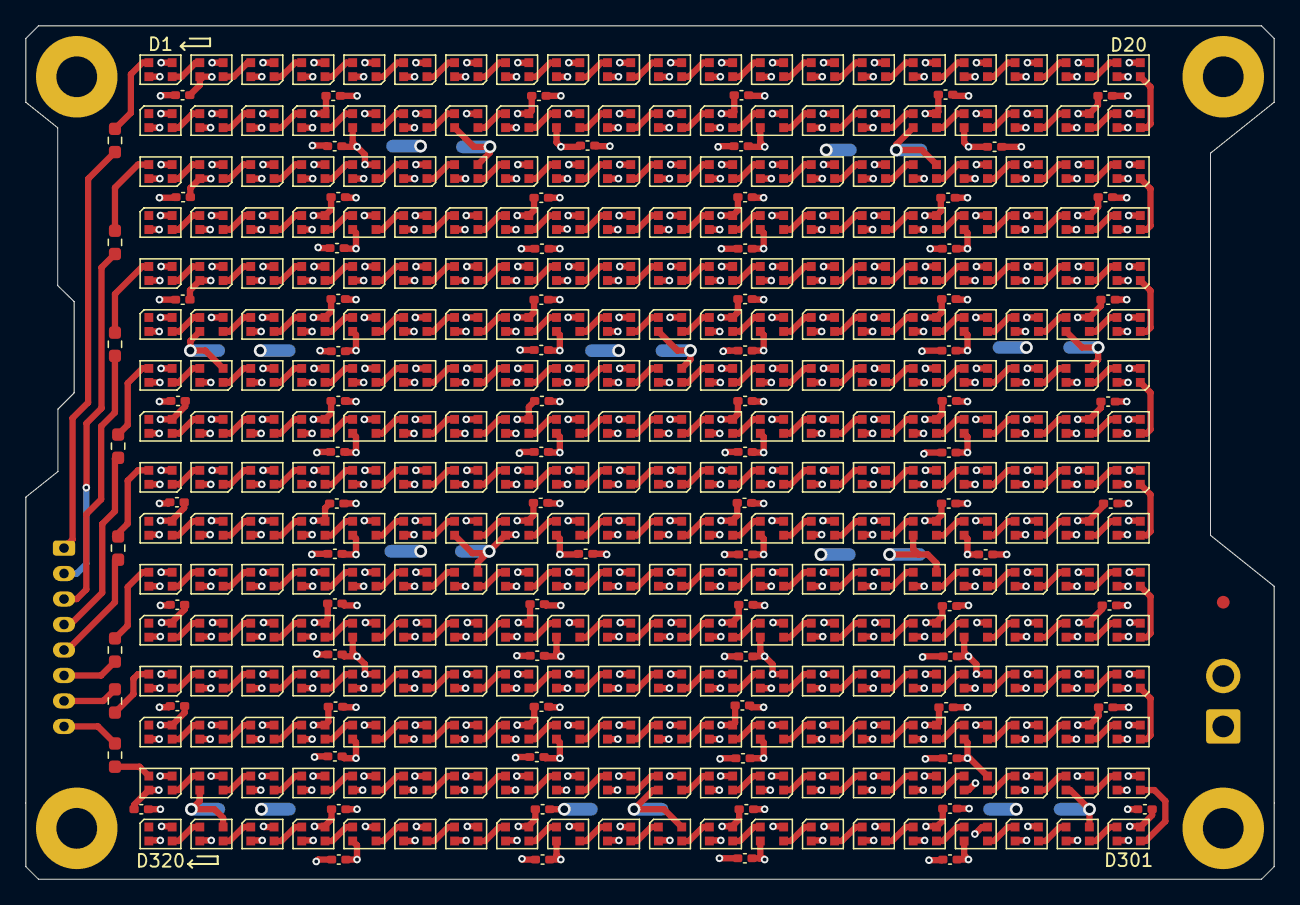
[picture p6: board display.kicad_pcb from above]

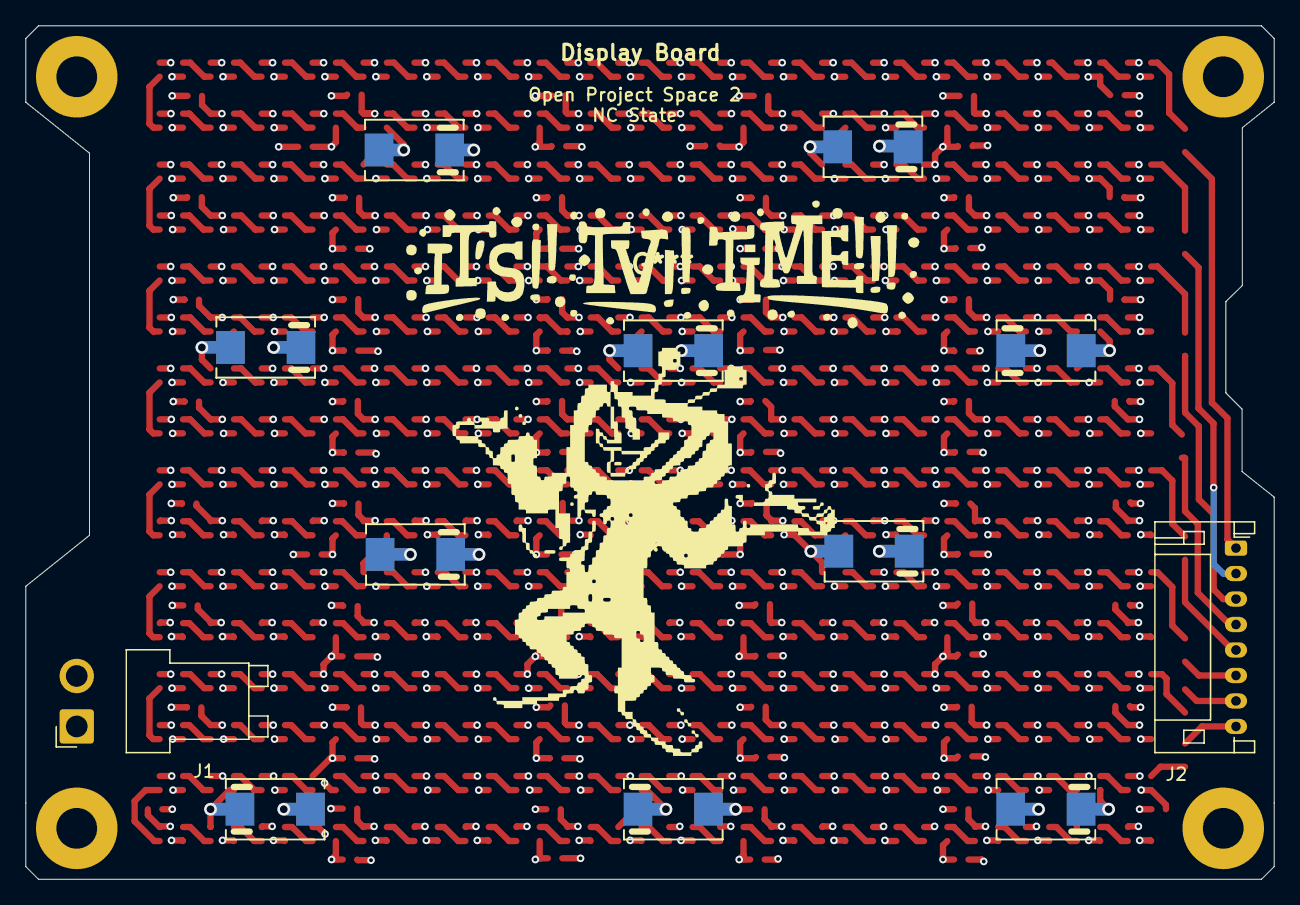
[picture p7: board display.kicad_pcb from below]

Board: 4 copper layers, 98.0 x 67.0 mm, 425 parts (12 on the bottom side), 330 nets.
