jacob-wigent/esp32-handheld/(commit log)

2025-09-29 Project Setup
    Added empty KiCad project for display PCB and empty PlatformIO project for OPS2 ESP32-S3 dev-board
    [display.kicad_pcb, display.kicad_sch]
2025-10-07 USB Interface and Started Power Management
    [esp32_test.kicad_pcb, esp32_test.kicad_sch, usbc_interface.kicad_sch]
2025-10-07 Basic Microcontroller Stuff and Display Power
    [esp32_test.kicad_sch]
2025-10-07 Changed GitIgnore
    [esp32_test.kicad_sch, usbc_interface.kicad_sch]
2025-10-07 Updated GitIgnore
    Changed Gitignore to ignore backup generation
    [esp32_test.kicad_sch]
2025-10-07 Fixed Capacitors
    [esp32_test.kicad_sch]
2025-10-08 Added USB C Power Monitoring and Start/Select
    also renamed project
    [motherboard.kicad_pcb, motherboard.kicad_sch]
2025-10-08 Updated GPIOs
    [motherboard.kicad_sch]
2025-10-08 Added Joystick
    [motherboard.kicad_sch]
2025-10-08 Added Joystick Symbol/Footprint
2025-10-08 Updated Custom Component Lib Sources
    [motherboard.kicad_sch]
2025-10-09 Started Display Layout
    [display.kicad_pcb, display.kicad_sch]
2025-10-09 Arranged LEDs
    Arranged NeoPixel footprints and handled schematic/PCB link and designations
    [display.kicad_pcb, display.kicad_sch]
2025-10-09 Basic Display PCB Layout
    [display.kicad_pcb]
2025-10-09 Added Silkscreen Screw Outlines
    [display.kicad_pcb]
2025-10-09 Fixed Screw Outlines
    [display.kicad_pcb]
2025-10-15 Added some notes
    [motherboard.kicad_sch]
2025-10-15 Added Connector Models
    Instructions included on how to import into KiCad library
    [display.kicad_pcb]
2025-10-15 Display Traces and Connector Placement
    Board is all connected and has no errors
    [display.kicad_pcb, display.kicad_sch]
2025-10-15 Moved Silkscreen Reference
    [display.kicad_pcb]
2025-10-16 Data Line Cleanup
    Moved some resistors and removed old, unnecessary vias.
    [display.kicad_pcb]
2025-10-16 Will Meeting
    Added JLC constraints
    [display.kicad_pcb, display.kicad_sch, motherboard.kicad_sch]
2025-10-21 Added assembly part numbers and schematic caps
    Linked LCSC part numbers for LEDs, decoupling caps, and data resistors.
    Added 10, 100uF caps in schematic, but footprints are needed still.
    [display-CuBottom.gbr, display-CuIn1.gbr, display-CuIn2.gbr, display-CuTop.gbr, display-EdgeCuts.gbr, display-MaskBottom.gbr, display-MaskTop.gbr, display-NPTH.drl]
2025-10-22 Added Motherboard PCB edge cut, added some footprints
    [motherboard.kicad_pcb, motherboard.kicad_sch]
2025-10-22 FIXED LIBRARIES!!!!!
    [display.kicad_pcb]
2025-10-22 Updated LED 3D model
    [display.kicad_pcb]
2025-10-22 Added footprints in motherboard, preparing for PCB layout
    [motherboard.kicad_sch]
2025-10-22 Added 100uF cap symbols and footprints
    Added symbols in schematic and footprints in PCB. Caps need layout and routing.
    [display.kicad_pcb, display.kicad_sch]
2025-10-22 Arranged/Routed 100uF Bulk Caps
    Manually routed each of the 10 caps by deleting 2 common NoePixel vias to make room for the pad, orienting the cap so VDD/GND is next to the deleted vias, and then routed VDD/GND into the one big via from the NeoPixels.
    [display.kicad_pcb, display.kicad_sch]
2025-10-22 Fixed a Via and Updated Silkscreen
    Changed one via position and added lines to indicate positive side of tant cap on silkscreen.
    [display.kicad_pcb]
2025-10-23 Charger, Started GPIO Assignments
    Added ESP32 devboard charger circuit and began assigning GPIOs. Provided lots of annotations and justifications for GPIO assignments.
    [motherboard.kicad_sch]
2025-10-23 JLC Build FIles
    [display-CuBottom.gbr, display-CuIn1.gbr, display-CuIn2.gbr, display-CuTop.gbr, display-EdgeCuts.gbr, display-MaskBottom.gbr, display-MaskTop.gbr, display-NPTH.drl]
2025-10-25 Motherboard Minor Annotation Updates
    [motherboard.kicad_pcb, motherboard.kicad_sch]
2025-10-25 Added CC Voltage Divider and Updated Charge LED Resistor
    [motherboard.kicad_sch]
2025-10-27 JLC Parts Update
    [display-CuBottom.gbr, display-CuIn1.gbr, display-CuIn2.gbr, display-CuTop.gbr, display-EdgeCuts.gbr, display-MaskBottom.gbr, display-MaskTop.gbr, display-NPTH.drl]
2025-10-27 Started Motherboard PCB Layout
    [motherboard.kicad_pcb, motherboard.kicad_sch]
2025-10-27 Cont. Motherboard Layout
    [motherboard.kicad_pcb, motherboard.kicad_sch]
2025-10-28 Routing 💀
    Layout and routing. Used 3v3 plane to route some power traces.
    Also added full size joystick model and footprint and schematic.
    [motherboard.kicad_pcb, motherboard.kicad_sch]
2025-10-28 Added dimension drawings to display board
    [display.kicad_pcb]
2025-10-28 Added Real Mounting Holes and Fiducial
    [display.kicad_pcb, display.kicad_sch]
2025-10-28 Will Notes
    [motherboard.kicad_pcb, motherboard.kicad_sch]
2025-10-28 lowkey idk
    [motherboard.kicad_pcb]
2025-10-28 Added Side Mount Button
2025-10-29 Updated motherboard, buttons are set, dimensions are visible
    [motherboard.kicad_pcb, motherboard.kicad_sch]
2025-10-29 Moved Test Points
    [motherboard.kicad_pcb]
2025-10-30 Added bumper buttons
    [motherboard.kicad_pcb, motherboard.kicad_sch]
2025-10-30 Adjusted Bumper Button Positions
    [motherboard.kicad_pcb]
2025-10-30 12mm Corners
    [motherboard.kicad_pcb]
2025-10-30 Adjusted Data Traces
    Made display data traces and SDA/SCL a little thinner
    [motherboard.kicad_pcb]
2025-10-30 Reset Button
    SMD Reset button on back behind MCU
    [motherboard.kicad_pcb, motherboard.kicad_sch]
2025-10-30 Added IMU Model
    [motherboard.kicad_pcb]
2025-10-30 Moved ABat Voltage Divider
    [motherboard.kicad_pcb]
2025-10-30 Added header file that defines our current pins
2025-10-30 Right Side Controls Routing
    [motherboard.kicad_pcb, motherboard.kicad_sch]
2025-10-30 Routed Joystick
    [motherboard.kicad_pcb, motherboard.kicad_sch]
2025-10-30 Routed Charge Stat to MCU
    [motherboard.kicad_pcb]
2025-10-30 Labelled Test Points
    [motherboard.kicad_pcb]
2025-10-30 Labelled power connectors on Motherboard
    [motherboard.kicad_pcb]
2025-10-30 Updated Schematic, Added motor/speaker connector
    [motherboard.kicad_pcb, motherboard.kicad_sch]
2025-10-30 Updated Mounting Holes
    M2 screw holes for M2x4mm screws into top of case.
    [display.kicad_pcb, display.kicad_sch]
2025-10-30 Added ucbc 3d model
    [display.kicad_pcb, motherboard.kicad_pcb, motherboard.kicad_sch]
2025-10-30 Updated Motherboard
    [motherboard.kicad_pcb, motherboard.kicad_sch]
2025-10-31 Updated Mounting Holes
    Made display holes M3
    Matching hole pattern on motherboard to mount display.
    Distributed 4, M3 mounting holes throuhout motherboard
    [display.kicad_pcb, display.kicad_sch, motherboard.kicad_pcb, motherboard.kicad_sch]
2025-10-31 Added status LED trace
    [motherboard.kicad_pcb]
2025-10-31 Modify motherboard
    [motherboard.kicad_pcb]
2025-10-31 Motherboard Traces
    [motherboard.kicad_pcb]
2025-10-31 Expanded Mouting hole Margins, modified traces
    [display.kicad_pcb, motherboard.kicad_pcb]
2025-11-03 WIP Motherboard and Display Revisions
    [display.kicad_pcb, motherboard.kicad_pcb]
2025-11-03 WIP Continued – Display
    [display.kicad_pcb, display.kicad_sch]
2025-11-03 Display done
    [display.kicad_pcb]
2025-11-03 Adjusted Button position on display
    [display.kicad_pcb]
2025-11-03 Modified Display Traces
    Added space between display data traces where they were very close to other traces/pads.
    Increased size of traces from bulk caps to vias.
    [display.kicad_pcb]
2025-11-03 Small changes to motherboard traces
    [motherboard.kicad_pcb]
2025-11-03 Updated Motherboard and Minor Display Changes
    Updated Joystick Position, Moved Display Board Port
    other small fixes
    [display.kicad_pcb, motherboard.kicad_pcb, motherboard.kicad_sch]
2025-11-04 Add README and update pin definitions; implement LED control and animation patterns
2025-11-04 ERC and DRC Checks
    Made slight modifications to schematics and layouts to ensure ERCs and DRCs pass on both boards.
    Made some exclusions for irrelevant warnings.
    [display.kicad_pcb, display.kicad_sch, motherboard.kicad_pcb, motherboard.kicad_sch]
2025-11-04 Confirmed Thermal Reliefs and Re-filled Zones
    [display.kicad_pcb, motherboard.kicad_pcb]
2025-11-04 Stickers 🤩
    Added sticker footprints
2025-11-04 Added silkscreen graphics
    [motherboard.kicad_pcb]
2025-11-04 Finalized board, added art, ready to submit
    [display.kicad_pcb, motherboard.kicad_pcb]
2025-11-04 DFM Checks Passed, Board Submitted
    [display-CuBottom.gbr, display-CuIn1.gbr, display-CuIn2.gbr, display-CuTop.gbr, display-EdgeCuts.gbr, display-MaskBottom.gbr, display-MaskTop.gbr, display-NPTH.drl]
2025-11-05 Moved non-native step files into project library folder
    [display.kicad_pcb]
2025-11-19 Added battery charging serial outputs for debugging MCP73831
2025-11-25 Added Models for Power Components
    [motherboard.kicad_pcb]
2025-11-28 Updated 3d models for motherboard
    [motherboard.kicad_pcb]
2026-05-14 Begin custom Neopixel driver
2026-05-14 Achieve proof of concept Neopixel driver
2026-05-14 Finish RMT Neopixel driver
    RMT method works but only for 4 segments. Alternative method will be necessary to achieve 8-way control.
2026-05-14 Fix temp display ranges
    [main.c]
